MatzElectronics/Apple-IIc-Keyboard/README.md

# Apple *II*c Keyboard
Replacement keyboard for the Apple *II*c computer



[Available for purchase on my store at Tindie.com](https://www.tindie.com/products/matzelectronics/apple-iic-keyboard/)
