MatzElectronics/Apple-IIc-Keyboard/Firmware/README.md

This firmware uses the Arduino IDE with [megaTinyCore](https://github.com/SpenceKonde/megaTinyCore) by SpenceKnode.

It is programmed using the UPDI interface.
