MatzElectronics/Apple-IIc-Keyboard/Reference/README.md

This folder contains helpful reference material from the original Apple II series computers.

Source: [https://www.reactivemicro.com/](https://www.reactivemicro.com/)
