MatzElectronics/Apple-IIc-Keyboard/Parts - Apple IIc Replacement Keyboard.step

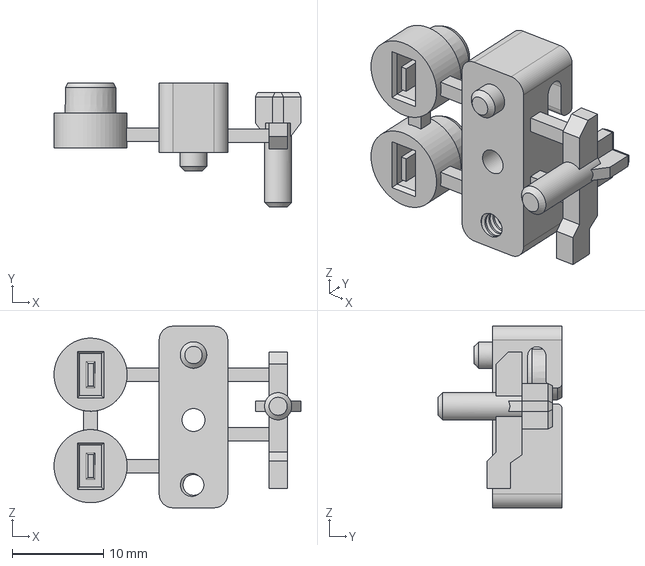
[picture p1: CAD file, 2024-10-15]
Parts - Apple IIc Replacement Keyboard.step
27.0 x 13.5 x 19.8 mm
