MatzElectronics/Apple-IIc-Keyboard/Schematic - Apple IIc Replacement Keyboard.pdf

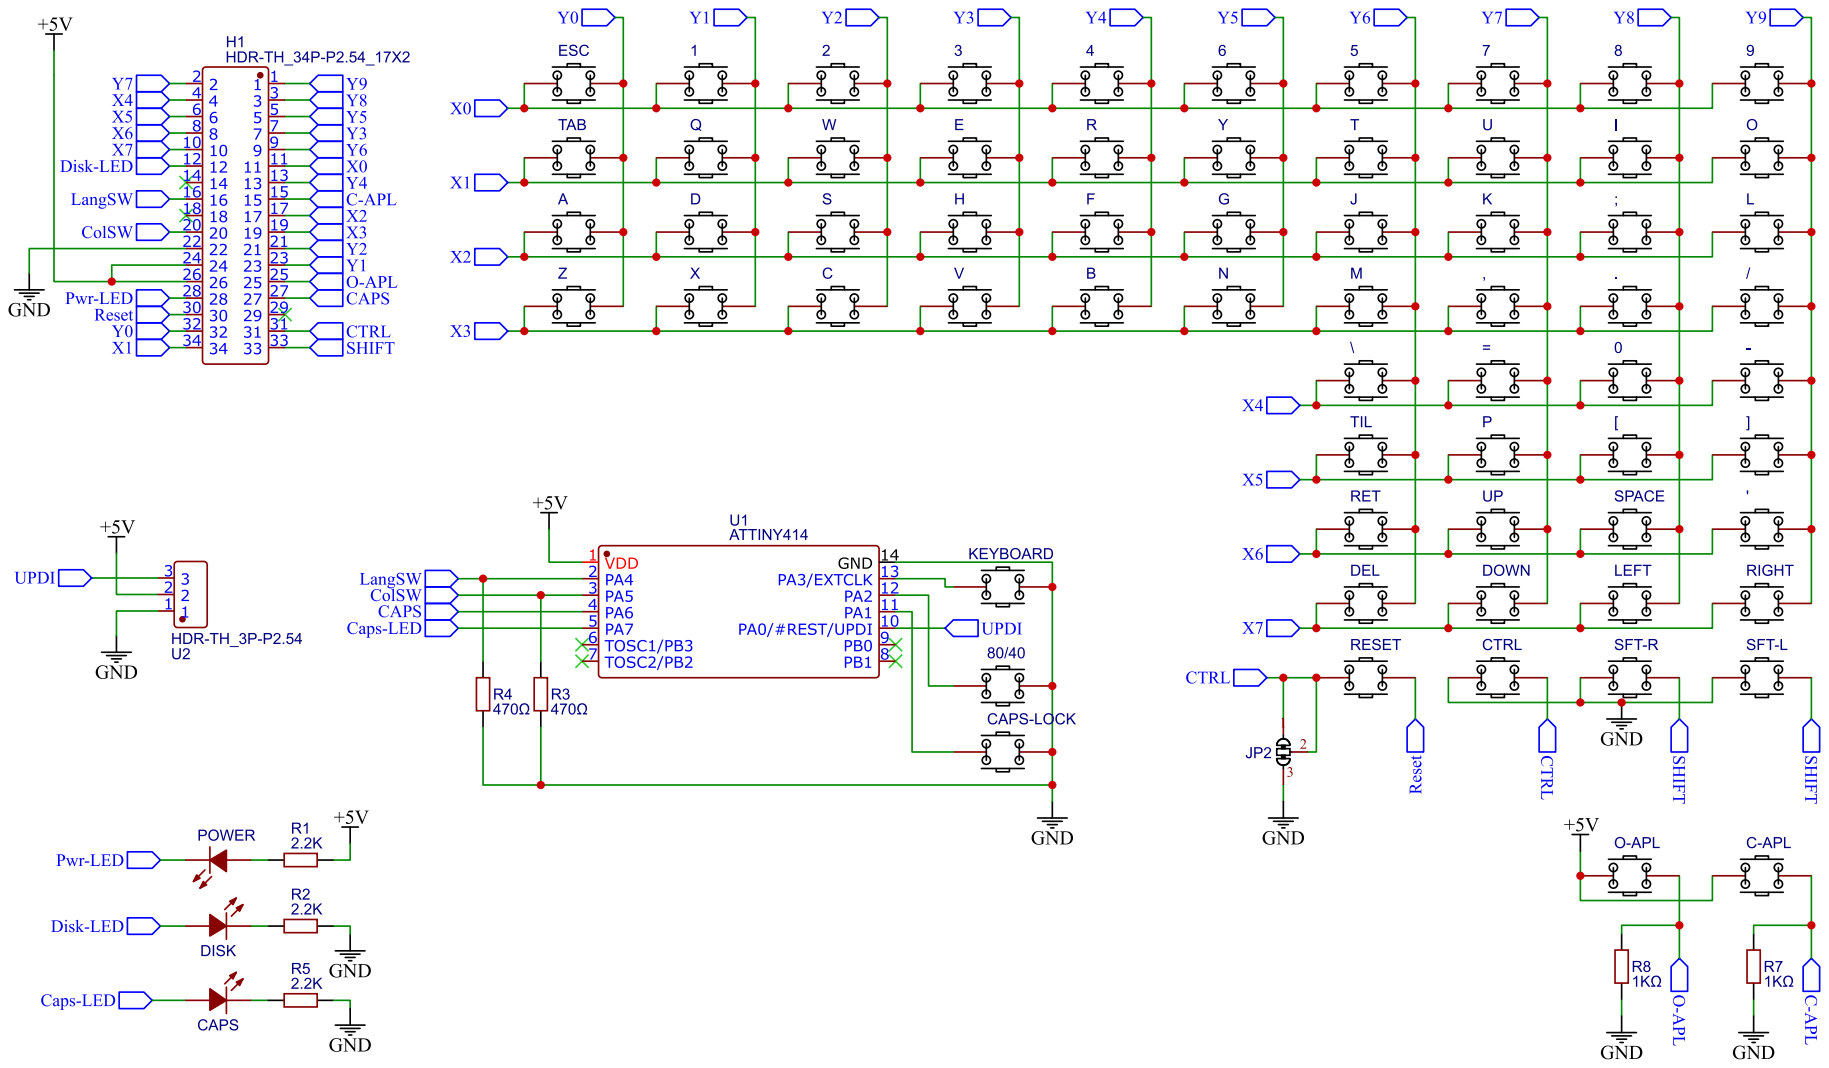
[picture p2: page 1]
