MatzElectronics/Apple-IIc-Keyboard/PCB - Apple IIc Replacement Keyboard.pdf

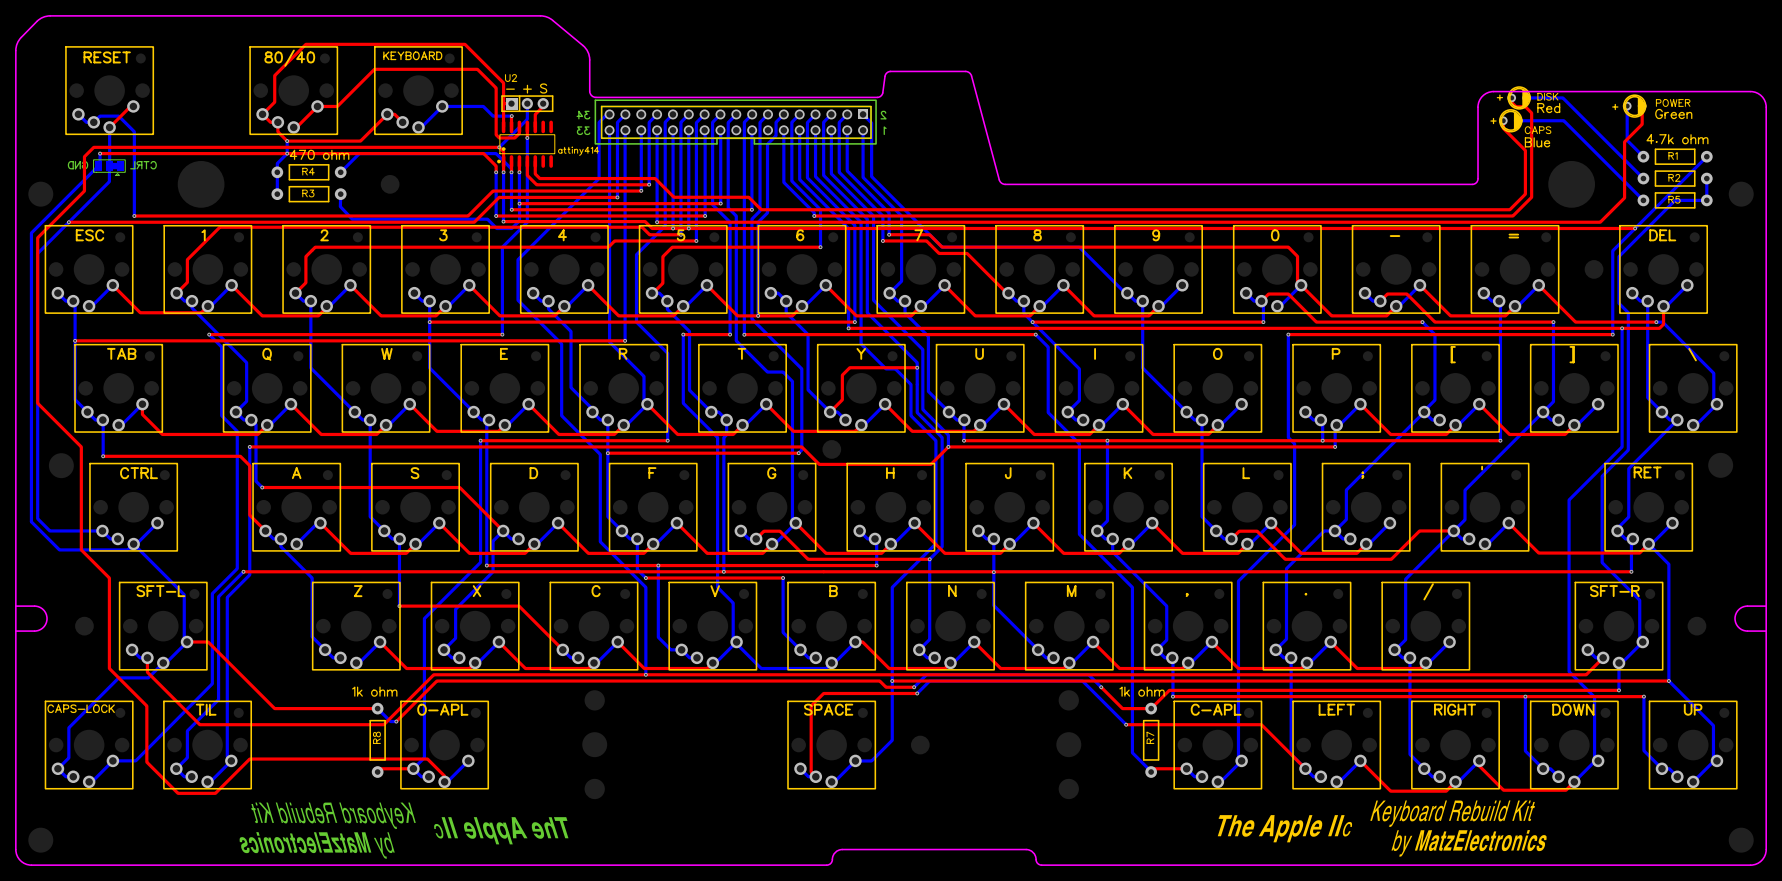
[picture p3: page 1]
