MatzElectronics/Apple-IIc-Keyboard/Testing/Keyboard to Pico Connections.md

## Apple IIc Keyboard to USB Converter using a Raspberry Pi Pico and CircuitPython

Connections:

| Name | Pico Pin | Connector Pin | Connector Pin | Pico Pin | Name |
| ----:|:---:|:---:|:---:|:---:|:---- |
| Row 7 | 16 | 1  | 2  | 15 | Row 9 |
| Col 4 | 17 | 3  | 4  | 14 | Row 8 |
| Col 5 | 18 | 5  | 6  | 13 | Row 5 |
| Col 6 | 19 | 7  | 8  | 12 | Row 3 |
| Col 7 | 20 | 9  | 10 | 11 | Row 6 |
| Disk LED | - | 11 | 12 | 10 | Col 0 |
| - | - | 13 | 14 | 9  | Row 4 |
| Keyboard Key | - | 15 | 16 | 8  |  Key |
| - | - | 17 | 18 | 7  | Col 2 |
| 80/40 Key | - | 19 | 20 | 6  | Col 3 |
| GND | GND | 21 | 22 | 5  | Row 2 |
| VCC | 3V | 23 | 24 | 4  | Row 1 |
| - | - | 25 | 26 | 3  |  Key |
| Power LED | - | 27 | 28 | 2  | Caps Key |
| Reset Key | 26 | 29 | 30 | -  | - |
| Row 0 | 27 | 31 | 32 | 1  | Control Key |
| Col 1 | 28 | 33 | 34 | 0  | Shift Keys |

Connect the Keyboard Key to the Disk LED

Connect the 80/40 Key to the Power LED
