MatzElectronics/Apple-IIc-Keyboard/(commit log)

2024-10-15 Create Apple IIc Replacement Keyboard.ino
    [Apple IIc Replacement Keyboard.ino]
2024-10-15 Rename Apple IIc Keyboard Parts v7.step to Parts - Apple IIc Replacement Keyboard.step
    [Parts - Apple IIc Replacement Keyboard.step]
2024-10-16 Create Keyboard to Pico Connections.md
2024-10-20 Update Keyboard to Pico Connections.md
